uastw-embsys/bmi088_breakout_board/docs/bmi088_breakout.pdf

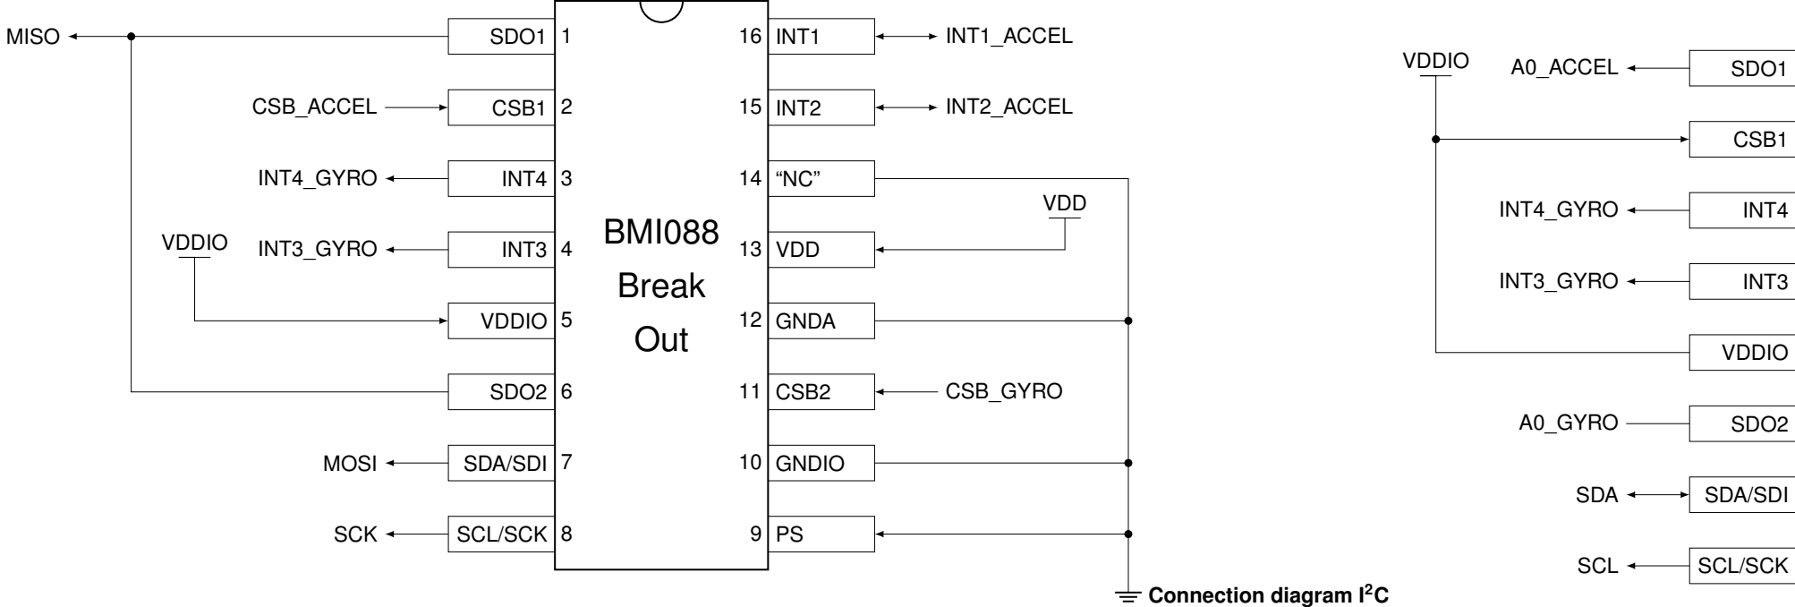
[picture p3: figure]
BMI088; Break; Out; MISO; SDO1; CSB_ACCEL; CSB1; INT4_GYRO; INT4; INT3_GYRO; INT3 VDDIO; VDDIO; SDO2; MOSI; SDA/SDI; SCK; SCL/SCK; GNDIO; CSB2; CSB_GYRO; GNDA; VDD; INT2; INT2_ACCEL; INT1; INT1_ACCEL; Connection diagram I; A0_ACCEL; SDO1 VDDIO; INT3; A0_GYRO; SDA; SCL
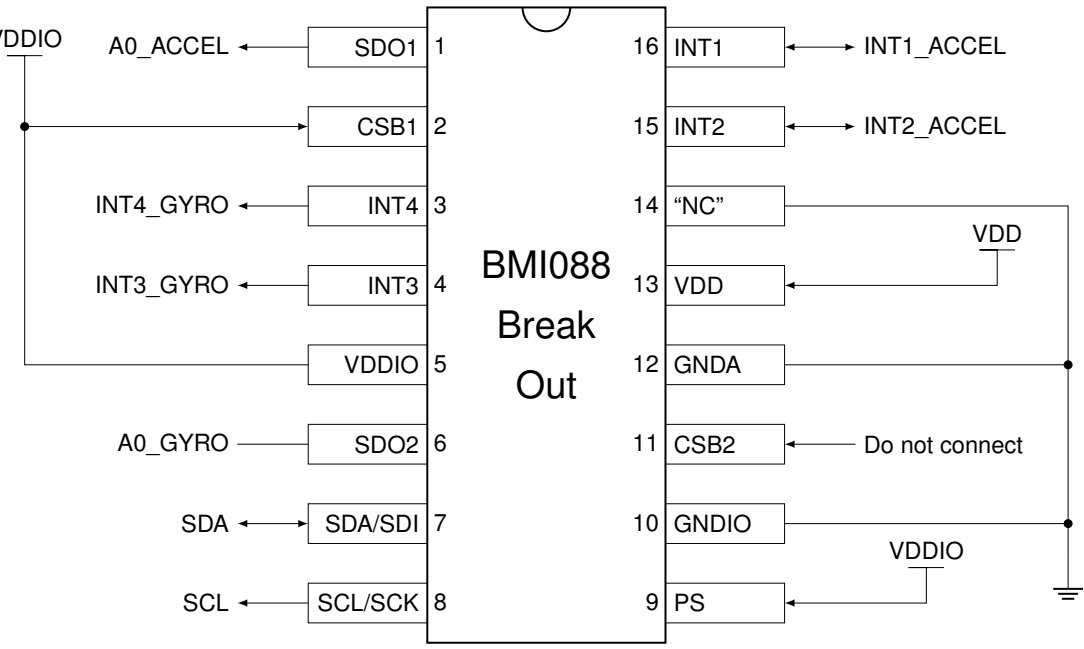
[picture p4: figure]
BMI088; Break; Out; VDDIO; GNDIO; CSB2; Do not connect; GNDA; VDD; INT2; INT2_ACCEL; INT1; INT1_ACCEL
