uastw-embsys/bmi088_breakout_board/kicad_rev2/bmi088/BMI088.step

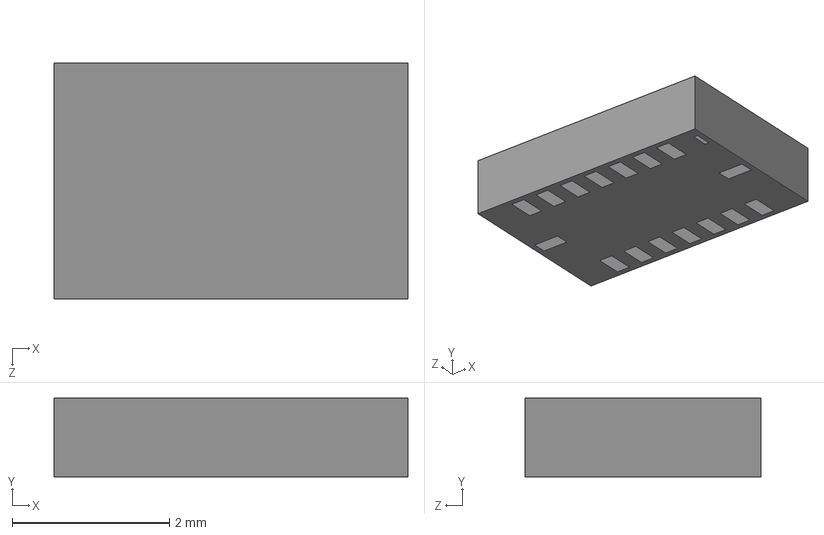
[picture p5: CAD file, 2025-01-29]
kicad_rev2/bmi088/BMI088.step
4.50 x 1.00 x 3.00 mm
