uastw-embsys/bmi088_breakout_board/docs/bmi088_breakout_I2C.pdf

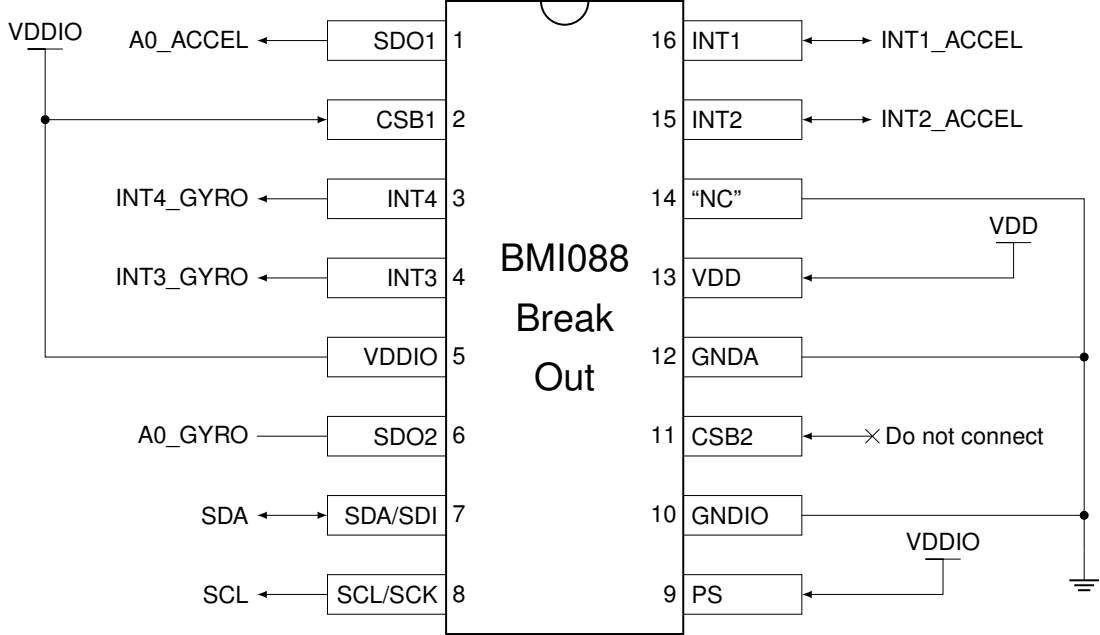
[picture p6: page 1]
BMI088; Break; Out; A0_ACCEL; SDO1 VDDIO; CSB1; INT4_GYRO; INT4; INT3_GYRO; INT3; VDDIO; A0_GYRO; SDO2; SDA; SDA/SDI; SCL; SCL/SCK; GNDIO; CSB2; Do not connect; GNDA; VDD; INT2; INT2_ACCEL; INT1; INT1_ACCEL
