uastw-embsys/bmi088_breakout_board/panel_rev2/panel/panel.kicad_pcb

## KiCad design panel_rev2/panel/panel.kicad_pcb (2026-04-08)

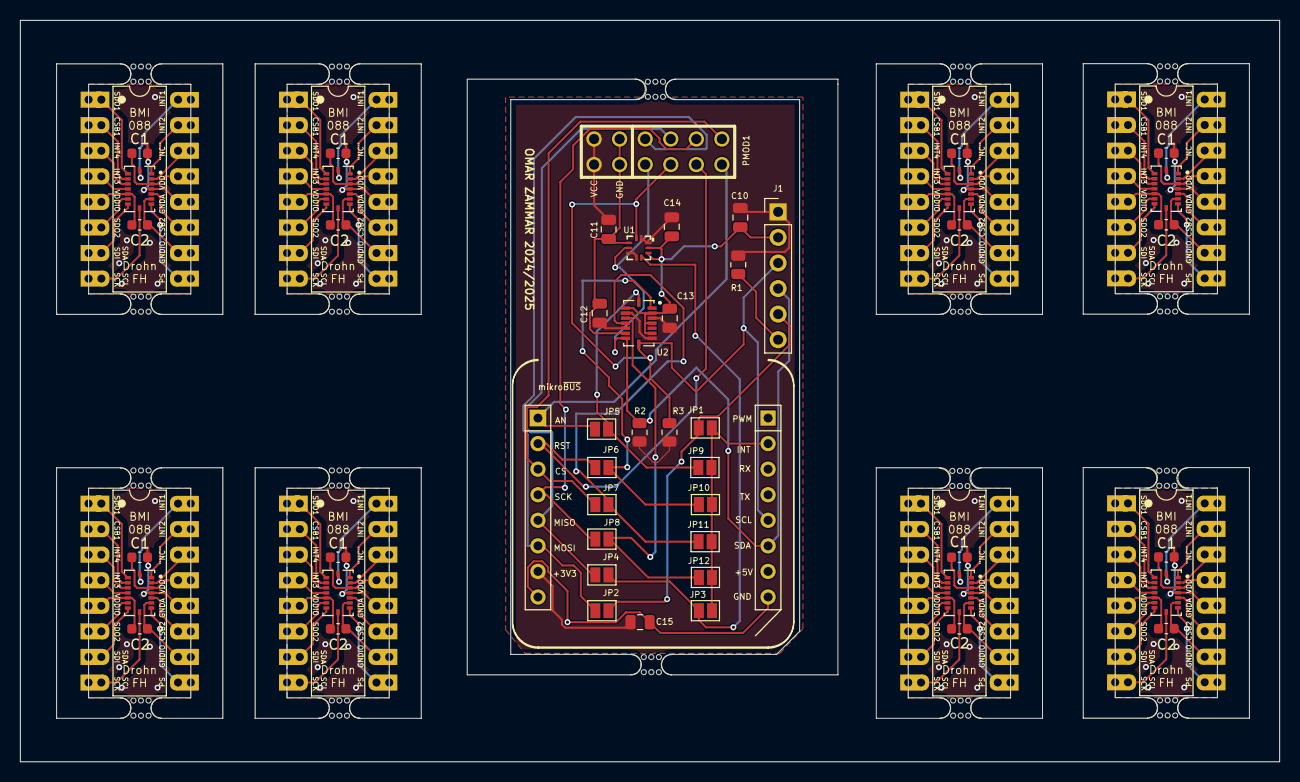
[picture p7: board panel.kicad_pcb from above]

Board: 2 copper layers, 125.1 x 73.7 mm, 76 parts (0 on the bottom side), 34 nets.

Parts:
C1, C2, C3, C4, C5, C6, C7, C8, C9, C21, C22, C23, C24, C25, C26, C27: 100n; C_0603_1608Metric
C10, C11, C12, C13, C14, C15: 100n; C_0805_2012Metric
CON1: MIKROBUS_HOST_CONN_IN_GND; MIKROBUS_HOST_CONN
J1: Conn_01x06; PinHeader_1x06_P2.54mm_Vertical
J1#2, J2, J3, J4, J5, J6, J7, J8: Conn_02x08_Counter_Clockwise; castello
JP1, JP2, JP3, JP4, JP5, JP6, JP7, JP8, JP9, JP10, JP11, JP12: SolderJumper_2_Open; SolderJumper-2_P1.3mm_Open_Pad1.0x1.5mm
PMOD1: PMOD-Device-x2-Type-1A-GPIO_1; pmod_pin_array_6x2
R1, R2, R3: 4.7k; R_0805_2012Metric
U1: BMP390; 10LGA_2X2X0p75_BOS
U2, U3, U4, U5, U6, U7, U8, U9, U10: BMI088; PQFN50P450X300X100-16N
mouse-bite-2mm-slot, mouse-bite-2mm-slot#2, mouse-bite-2mm-slot#3, mouse-bite-2mm-slot#4, mouse-bite-2mm-slot#5, mouse-bite-2mm-slot#6, mouse-bite-2mm-slot#7, mouse-bite-2mm-slot#8, mouse-bite-2mm-slot#9, mouse-bite-2mm-slot#10, mouse-bite-2mm-slot#11, mouse-bite-2mm-slot#12, mouse-bite-2mm-slot#13, mouse-bite-2mm-slot#14, mouse-bite-2mm-slot#15, mouse-bite-2mm-slot#16, mouse-bite-2mm-slot#17, mouse-bite-2mm-slot#18: VAL**; mouse-bite-2mm-slot

Connections:
/3V3: C10.1, C11.1, C12.1, C13.1, C14.1, C15.1, CON1.P7 (3V3), J1.1, PMOD1.6 (VCC), PMOD1.12 (VCC), R1.2, R2.1, R3.1, U1.1 (VDDIO), U1.5 (SDO), U1.6 (CSB), U1.10 (VDD), U2.3 (VDD), U2.7 (PS), U2.11 (VDDIO), U2.14 (CSB1)
/BARO_INT: CON1.P5 (MISO), JP4.2 (B), PMOD1.9 (IOB2)
/CSB1: J1#2.2, J2.2, J3.2, J4.2, J5.2, J6.2, J7.2, J8.2, U3.14 (CSB1), U4.14 (CSB1), U5.14 (CSB1), U6.14 (CSB1), U7.14 (CSB1), U8.14 (CSB1), U9.14 (CSB1), U10.14 (CSB1)
/CSB2: J1#2.11, J2.11, J3.11, J4.11, J5.11, J6.11, J7.11, J8.11, U3.5 (CSB2), U4.5 (CSB2), U5.5 (CSB2), U6.5 (CSB2), U7.5 (CSB2), U8.5 (CSB2), U9.5 (CSB2), U10.5 (CSB2)
/DIST_INT: CON1.P6 (MOSI), JP2.1 (A), PMOD1.10 (IOB3)
/GNDA: C1.2, C3.2, C4.2, C5.2, C6.2, C7.2, C8.2, C9.2, J1#2.12, J2.12, J3.12, J4.12, J5.12, J6.12, J7.12, J8.12, U3.4 (GNDA), U4.4 (GNDA), U5.4 (GNDA), U6.4 (GNDA), U7.4 (GNDA), U8.4 (GNDA), U9.4 (GNDA), U10.4 (GNDA)
/GNDIO: C2.2, C21.2, C22.2, C23.2, C24.2, C25.2, C26.2, C27.2, J1#2.10, J2.10, J3.10, J4.10, J5.10, J6.10, J7.10, J8.10, U3.6 (GNDIO), U4.6 (GNDIO), U5.6 (GNDIO), U6.6 (GNDIO), U7.6 (GNDIO), U8.6 (GNDIO), U9.6 (GNDIO), U10.6 (GNDIO)
/IMU_INT 1: CON1.P1 (AN), JP5.2 (B), PMOD1.1 (IOA0)
/IMU_INT 2: CON1.P2 (RST), JP6.2 (B), PMOD1.2 (IOA1)
/IMU_INT 3: CON1.P3 (CS), JP7.2 (B), PMOD1.7 (IOB0)
/IMU_INT 4: CON1.P4 (SCK), JP8.2 (B), PMOD1.8 (IOB1)
/INT: CON1.P15 (INT), JP1.2 (B), JP3.2 (B), JP9.2 (B), JP10.2 (B), JP11.2 (B), JP12.2 (B)
/INT1: J1#2.16, J2.16, J3.16, J4.16, J5.16, J6.16, J7.16, J8.16, U3.16 (INT1), U4.16 (INT1), U5.16 (INT1), U6.16 (INT1), U7.16 (INT1), U8.16 (INT1), U9.16 (INT1), U10.16 (INT1)
/INT2: J1#2.15, J2.15, J3.15, J4.15, J5.15, J6.15, J7.15, J8.15, U3.1 (INT2), U4.1 (INT2), U5.1 (INT2), U6.1 (INT2), U7.1 (INT2), U8.1 (INT2), U9.1 (INT2), U10.1 (INT2)
/INT3: J1#2.4, J2.4, J3.4, J4.4, J5.4, J6.4, J7.4, J8.4, U3.12 (INT3), U4.12 (INT3), U5.12 (INT3), U6.12 (INT3), U7.12 (INT3), U8.12 (INT3), U9.12 (INT3), U10.12 (INT3)
/INT4: J1#2.3, J2.3, J3.3, J4.3, J5.3, J6.3, J7.3, J8.3, U3.13 (INT4), U4.13 (INT4), U5.13 (INT4), U6.13 (INT4), U7.13 (INT4), U8.13 (INT4), U9.13 (INT4), U10.13 (INT4)
/NC: J1#2.14, J2.14, J3.14, J4.14, J5.14, J6.14, J7.14, J8.14, U3.2 (NC), U4.2 (NC), U5.2 (NC), U6.2 (NC), U7.2 (NC), U8.2 (NC), U9.2 (NC), U10.2 (NC)
/PS: J1#2.9, J2.9, J3.9, J4.9, J5.9, J6.9, J7.9, J8.9, U3.7 (PS), U4.7 (PS), U5.7 (PS), U6.7 (PS), U7.7 (PS), U8.7 (PS), U9.7 (PS), U10.7 (PS)
/SCL: CON1.P12 (SCL), J1.3, PMOD1.3 (IOA2), R3.2, U1.2 (SCK), U2.8 (SCL/SCK)
/SCL/SCK: J1#2.8, J2.8, J3.8, J4.8, J5.8, J6.8, J7.8, J8.8, U3.8 (SCL/SCK), U4.8 (SCL/SCK), U5.8 (SCL/SCK), U6.8 (SCL/SCK), U7.8 (SCL/SCK), U8.8 (SCL/SCK), U9.8 (SCL/SCK), U10.8 (SCL/SCK)
/SDA: CON1.P11 (SDA), J1.4, PMOD1.4 (IOA3), R2.2, U1.4 (SDI), U2.9 (SDA/SDI)
/SDA_SDI: J1#2.7, J2.7, J3.7, J4.7, J5.7, J6.7, J7.7, J8.7, U3.9 (SDA/SDI), U4.9 (SDA/SDI), U5.9 (SDA/SDI), U6.9 (SDA/SDI), U7.9 (SDA/SDI), U8.9 (SDA/SDI), U9.9 (SDA/SDI), U10.9 (SDA/SDI)
/SDO1: J1#2.1, J2.1, J3.1, J4.1, J5.1, J6.1, J7.1, J8.1, U3.15 (SDO1), U4.15 (SDO1), U5.15 (SDO1), U6.15 (SDO1), U7.15 (SDO1), U8.15 (SDO1), U9.15 (SDO1), U10.15 (SDO1)
/SDO2: J1#2.6, J2.6, J3.6, J4.6, J5.6, J6.6, J7.6, J8.6, U3.10 (SDO2), U4.10 (SDO2), U5.10 (SDO2), U6.10 (SDO2), U7.10 (SDO2), U8.10 (SDO2), U9.10 (SDO2), U10.10 (SDO2)
/VDD: C1.1, C3.1, C4.1, C5.1, C6.1, C7.1, C8.1, C9.1, J1#2.13, J2.13, J3.13, J4.13, J5.13, J6.13, J7.13, J8.13, U3.3 (VDD), U4.3 (VDD), U5.3 (VDD), U6.3 (VDD), U7.3 (VDD), U8.3 (VDD), U9.3 (VDD), U10.3 (VDD)
/VDDIO: C2.1, C21.1, C22.1, C23.1, C24.1, C25.1, C26.1, C27.1, J1#2.5, J2.5, J3.5, J4.5, J5.5, J6.5, J7.5, J8.5, U3.11 (VDDIO), U4.11 (VDDIO), U5.11 (VDDIO), U6.11 (VDDIO), U7.11 (VDDIO), U8.11 (VDDIO), U9.11 (VDDIO), U10.11 (VDDIO)
GND: C10.2, C11.2, C12.2, C13.2, C14.2, C15.2, CON1.P8 (GND1), CON1.P9 (GND2), J1.2, PMOD1.5 (GND), PMOD1.11 (GND), U1.3 (VSS), U1.8 (VSS), U1.9 (VSS), U2.2 (NC), U2.4 (GNDA), U2.6 (GNDIO), U2.10 (SDO2), U2.15 (SDO1)
unnamed: J1.5, JP1.1 (A), JP2.2 (B)
unnamed: J1.6, R1.1
unnamed: JP3.1 (A), JP4.1 (A), U1.7 (INT)
unnamed: JP5.1 (A), JP9.1 (A), U2.16 (INT1)
unnamed: JP6.1 (A), JP10.1 (A), U2.1 (INT2)
unnamed: JP7.1 (A), JP11.1 (A), U2.12 (INT3)
unnamed: JP8.1 (A), JP12.1 (A), U2.13 (INT4)
