uastw-embsys/bmi088_breakout_board/kicad_rev2/bmi088_breakout_board.kicad_pcb

## KiCad design kicad_rev2/bmi088_breakout_board.kicad_pcb (2026-04-08)

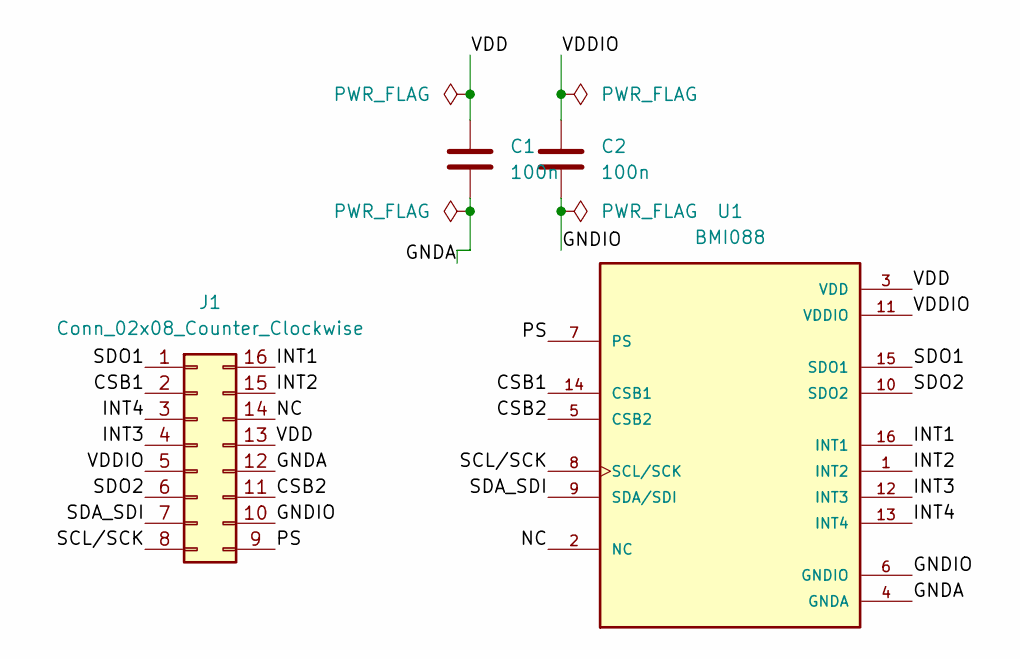
[picture p8: schematic bmi088_breakout_board.kicad_sch]

Parts:
C1, C2: 100n; C_0603_1608Metric
J1: Conn_02x08_Counter_Clockwise; castello
U1: BMI088; PQFN50P450X300X100-16N

Connections:
/CSB1: J1.2, U1.14 (CSB1)
/CSB2: J1.11, U1.5 (CSB2)
/GNDA: C1.2, J1.12, U1.4 (GNDA)
/GNDIO: C2.2, J1.10, U1.6 (GNDIO)
/INT1: J1.16, U1.16 (INT1)
/INT2: J1.15, U1.1 (INT2)
/INT3: J1.4, U1.12 (INT3)
/INT4: J1.3, U1.13 (INT4)
/NC: J1.14, U1.2 (NC)
/PS: J1.9, U1.7 (PS)
/SCL/SCK: J1.8, U1.8 (SCL/SCK)
/SDA_SDI: J1.7, U1.9 (SDA/SDI)
/SDO1: J1.1, U1.15 (SDO1)
/SDO2: J1.6, U1.10 (SDO2)
/VDD: C1.1, J1.13, U1.3 (VDD)
/VDDIO: C2.1, J1.5, U1.11 (VDDIO)

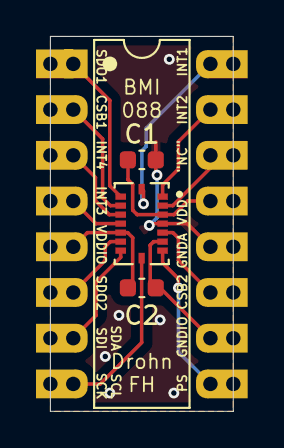
[picture p9: board bmi088_breakout_board.kicad_pcb from above]

Board: 2 copper layers, 10.2 x 20.8 mm, 4 parts (0 on the bottom side), 16 nets.
