uastw-embsys/bmi088_breakout_board/STM32/bmi088-hello-spi/bmi088-hello-spi.ioc

Mcu.UserName=STM32L432KCUx
PA2.Signal=USART2_TX
PB0.Signal=GPIO_Output
PB1.Signal=GPIO_Output
PB5.Signal=SPI1_MOSI
PB6.Signal=I2C1_SCL
PB7.Signal=I2C1_SDA
