uastw-embsys/bmi088_breakout_board/(commit log)

2025-03-19 Add SPI example
2026-04-08 Add Rev2
    [BMI088.step, bmi088_breakout_board.kicad_pcb, bmi088_breakout_board.kicad_sch, panel.csv, panel.kicad_pcb, panel.kicad_sch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]
