uastw-embsys/bmi088_breakout_board/(notices)

Notices in the files:
STM32/bmi088-hello-spi/Core/Src/main.c:
All rights reserved.
